ear0/ECE445_Team18/README.md

# S-band Radar Altimeter
Welcome to Team 18's engineering notebook detailing our attempt to build a radar altimeter.

Team members: Bobby Sommers, Elliot Rubin, Rayan Nehme

thumbnail_IMG_4961
