ear0/ECE445_Team18/notebooks/rayan/73459145394__DBE7241A-3E8F-4A33-9CC1-7CEE9B650594.pdf

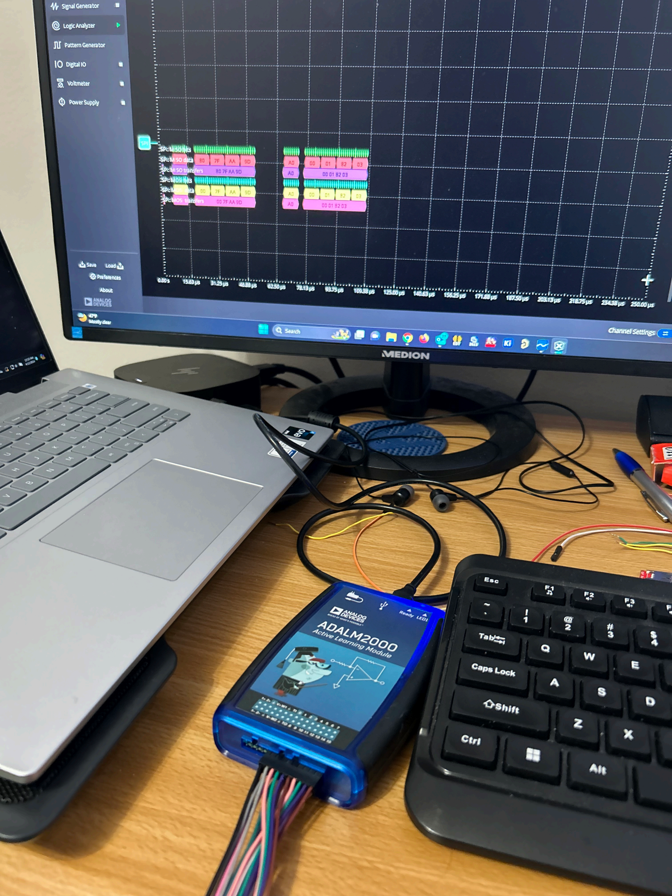
[picture p11: page 1]
