ear0/ECE445_Team18/hardware/pcb/Radar2_ExtFilter/some_s_params/Terminal S Parameter Plot 1.csv

$e_r [] | TraceW [mm] | Freq [GHz] | dB(St(Trace_T1,Trace_T1)) [] | dB(St(Trace_T2,Trace_T2)) []
4.2 | 0.15 | 2 | -15.2933460259408 | -14.9864315408136
4.2 | 0.15 | 2.0025 | -15.2792393182591 | -14.9737543382061
4.2 | 0.15 | 2.005 | -15.2651536047298 | -14.9610933365723
4.2 | 0.15 | 2.0075 | -15.2510889968198 | -14.9484486654774
4.2 | 0.15 | 2.01 | -15.2370456068577 | -14.9358204513786
4.2 | 0.15 | 2.0125 | -15.2230235480281 | -14.9232088178172
4.2 | 0.15 | 2.015 | -15.2090229343641 | -14.9106138856007
4.2 | 0.15 | 2.0175 | -15.1950438807411 | -14.8980357729761
4.2 | 0.15 | 2.02 | -15.1810865028692 | -14.8854745957944
4.2 | 0.15 | 2.0225 | -15.1671509172862 | -14.8729304676672
4.2 | 0.15 | 2.025 | -15.1532372413499 | -14.8604035001157
4.2 | 0.15 | 2.0275 | -15.1393455932309 | -14.8478938027121
4.2 | 0.15 | 2.03 | -15.1254760919041 | -14.8354014832142
4.2 | 0.15 | 2.0325 | -15.1116288571415 | -14.822926647694
4.2 | 0.15 | 2.035 | -15.0978040095032 | -14.8104694006593
4.2 | 0.15 | 2.0375 | -15.0840016703299 | -14.7980298451698
4.2 | 0.15 | 2.04 | -15.0702219617335 | -14.7856080829478
4.2 | 0.15 | 2.0425 | -15.056465006589 | -14.7732042144834
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
