ear0/ECE445_Team18/hardware/pcb/Radar2_ExtFilter/some_s_params/Zin.csv

$e_r [] | TraceW [mm] | Freq [GHz] | re(Zin) [] | im(Zin) []
4.2 | 0.15 | 2 | 42.0965059819982 | -13.927181922279
4.2 | 0.15 | 2.0025 | 42.0674469992557 | -13.9351497485285
4.2 | 0.15 | 2.005 | 42.0383466433968 | -13.9430374163889
4.2 | 0.15 | 2.0075 | 42.0092052572373 | -13.9508445249915
4.2 | 0.15 | 2.01 | 41.9800231885834 | -13.9585706745552
4.2 | 0.15 | 2.0125 | 41.9508007902491 | -13.9662154664471
4.2 | 0.15 | 2.015 | 41.9215384200723 | -13.9737785032422
4.2 | 0.15 | 2.0175 | 41.8922364409308 | -13.9812593887849
4.2 | 0.15 | 2.02 | 41.8628952207575 | -13.98865772825
4.2 | 0.15 | 2.0225 | 41.8335151325541 | -13.9959731282054
4.2 | 0.15 | 2.025 | 41.8040965544055 | -14.0032051966738
4.2 | 0.15 | 2.0275 | 41.7746398694918 | -14.0103535431966
4.2 | 0.15 | 2.03 | 41.7451454661006 | -14.0174177788969
4.2 | 0.15 | 2.0325 | 41.7156137376384 | -14.024397516544
4.2 | 0.15 | 2.035 | 41.6860450826408 | -14.0312923706177
4.2 | 0.15 | 2.0375 | 41.6564399047821 | -14.0381019573734
4.2 | 0.15 | 2.04 | 41.6267986128838 | -14.0448258949076
4.2 | 0.15 | 2.0425 | 41.5971216209233 | -14.051463803224
4.2 | 0.15 | 2.045 | 41.5674093480402 | -14.0580153042993
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
