ear0/ECE445_Team18/hardware/pcb/PA_EVAL/PA_EVAL_back.png

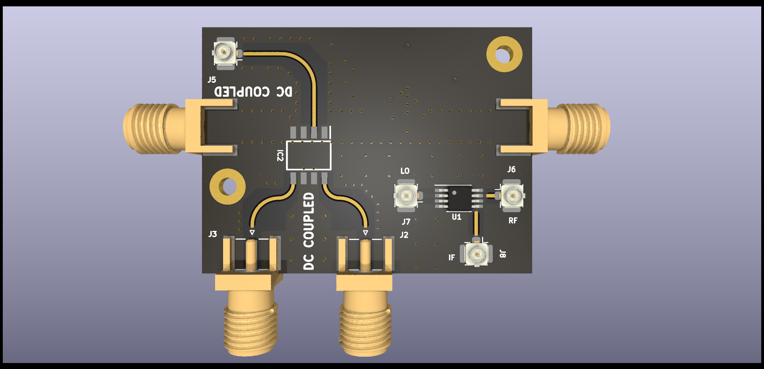
hardware/pcb/PA_EVAL/PA_EVAL_back.png
