ear0/ECE445_Team18/hardware/pcb/power_processing_unit/power_processing_unit.png

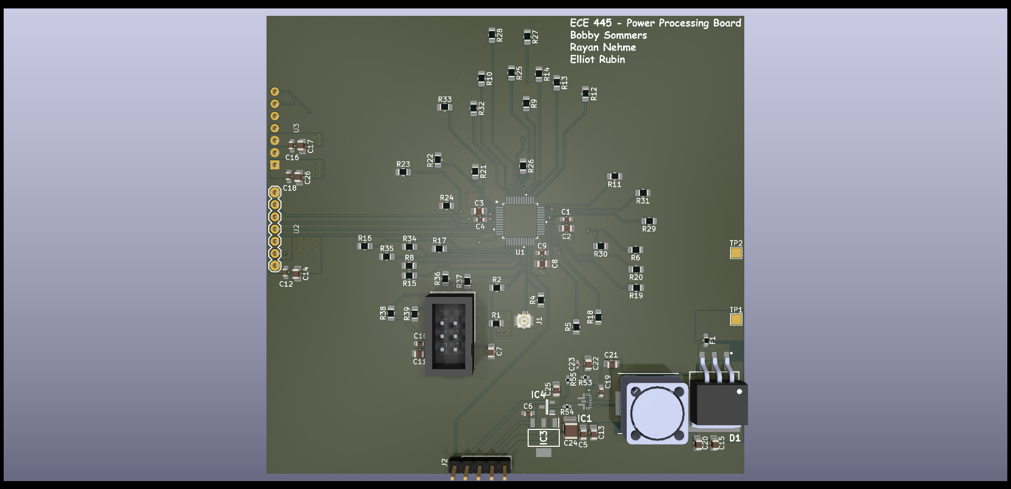
hardware/pcb/power_processing_unit/power_processing_unit.png
