ear0/ECE445_Team18/hardware/pcb/RadarV1.5/Radar2_ExtFilterUSE/Radar2_ExtFilter.png

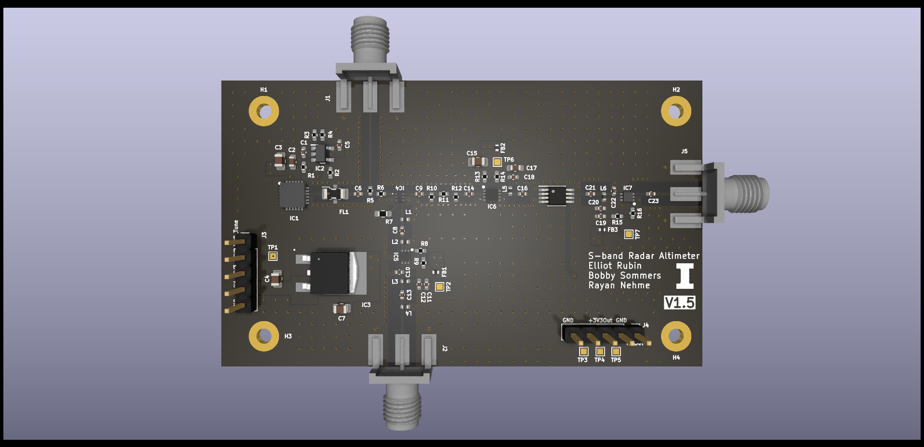
hardware/pcb/RadarV1.5/Radar2_ExtFilterUSE/Radar2_ExtFilter.png
