ear0/ECE445_Team18/hardware/pcb/PA_EVAL/PA_EVAL.step

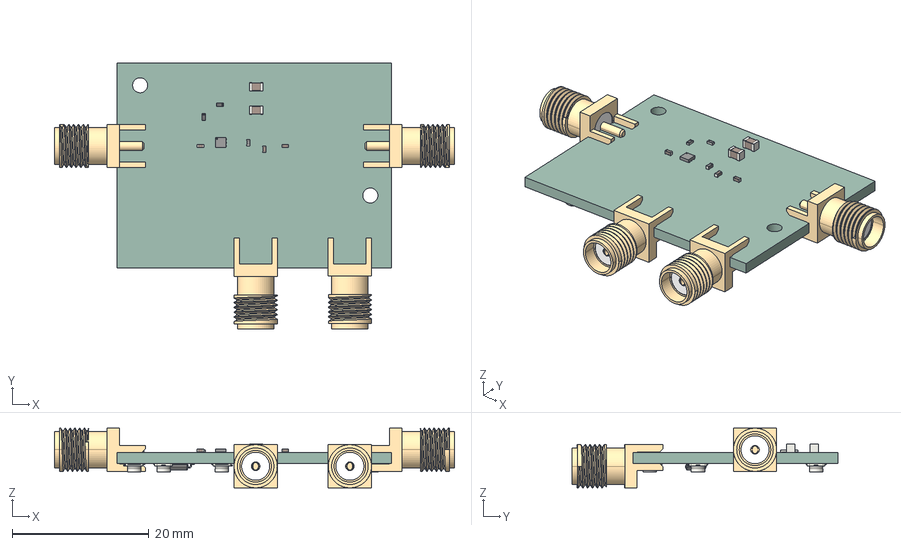
[picture p18: CAD file, 2024-05-02]
hardware/pcb/PA_EVAL/PA_EVAL.step
58.6 x 39.0 x 8.77 mm
R_0402_1005Metric x 2
C_0805_2012Metric x 2
C_0402_1005Metric x 3
ASSEMBLY
SMA-J-P-H-ST-EM1 x 4
L_0402_1005Metric
MSOP_8_3x3mm_P065mm
U.FL_Hirose_U.FL-R-SMT-1_Vertical x 4
PA_EVAL PCB
