ear0/ECE445_Team18/hardware/pcb/power_processing_unit/LIB_ADP150AUJZ-3/ADP150AUJZ-3.0-R7/3D/ADP150AUJZ-3.0-R7.stp

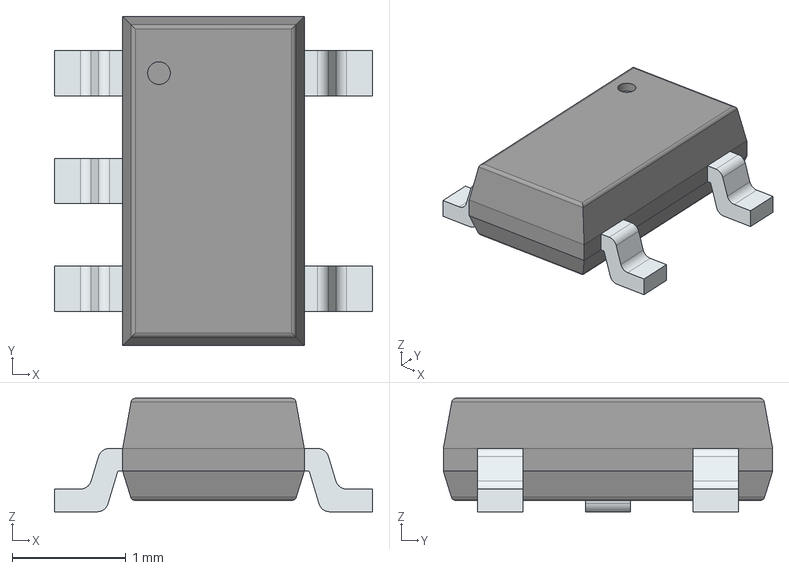
[picture p19: CAD file, 2024-05-02]
hardware/pcb/power_processing_unit/LIB_ADP150AUJZ-3/ADP150AUJZ-3.0-R7/3D/ADP150AUJZ-3.0-R7.stp
2.80 x 2.90 x 1.00 mm
PinsArrayL
PinsArrayR
