ear0/ECE445_Team18/hardware/pcb/power_processing_unit/LIB_AP7375-50SA-7/AP7375-50SA-7/3D/AP7375-50SA-7.stp

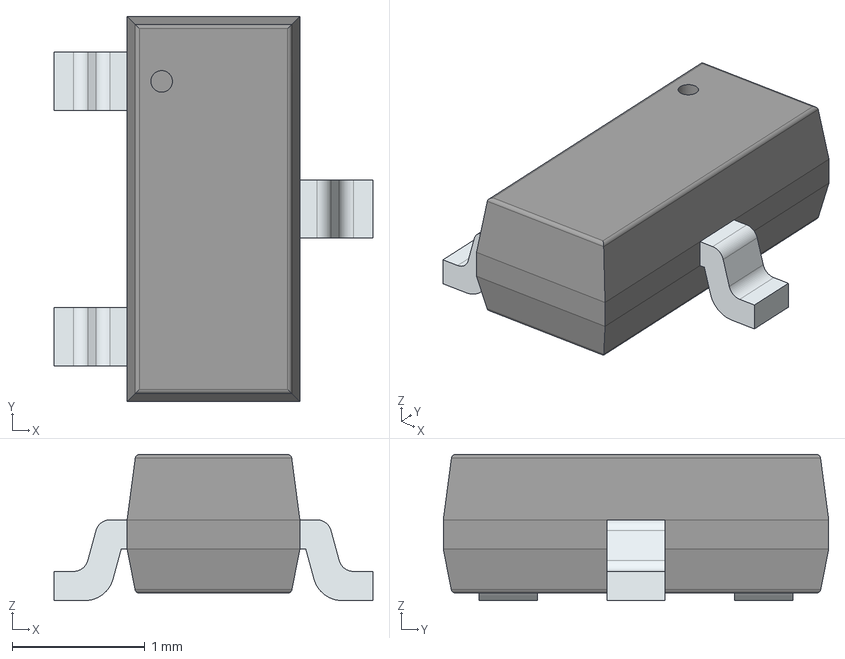
[picture p20: CAD file, 2024-05-02]
hardware/pcb/power_processing_unit/LIB_AP7375-50SA-7/AP7375-50SA-7/3D/AP7375-50SA-7.stp
2.40 x 2.90 x 1.10 mm
PinsArrayL
FilletPinR
