ear0/ECE445_Team18/hardware/pcb/power_processing_unit/LIB_AZ1117CH2-3/AZ1117CH2-3.3TRG1/3D/AZ1117CH2-3.3TRG1.stp

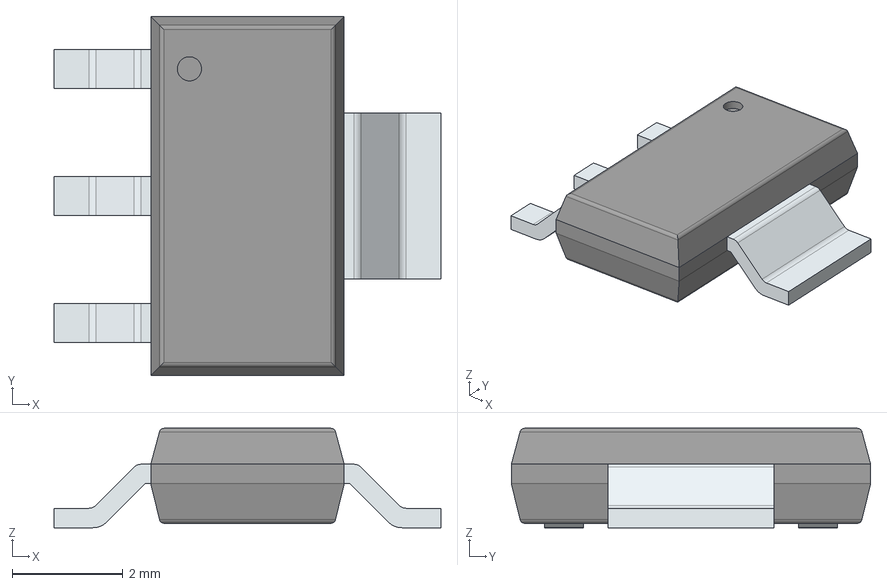
[picture p21: CAD file, 2024-05-02]
hardware/pcb/power_processing_unit/LIB_AZ1117CH2-3/AZ1117CH2-3.3TRG1/3D/AZ1117CH2-3.3TRG1.stp
7.00 x 6.50 x 1.80 mm
PinsArrayL
FilletPinR
