ear0/ECE445_Team18/hardware/pcb/power_processing_unit/LIB_DR127-3R3-R/DR127-3R3-R/3D/DR127-3R3-R.stp

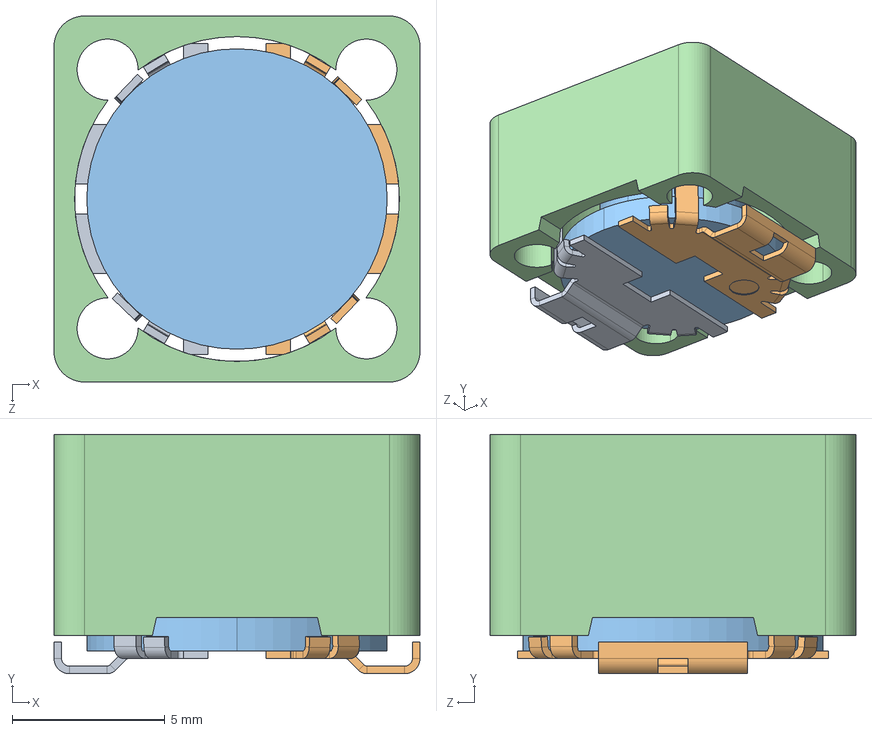
[picture p22: CAD file, 2024-05-02]
hardware/pcb/power_processing_unit/LIB_DR127-3R3-R/DR127-3R3-R/3D/DR127-3R3-R.stp
12.0 x 7.85 x 12.0 mm
40014700A
