ear0/ECE445_Team18/hardware/pcb/Radar2_ExtFilter/Imported Full_Radar/Radar2_ExtFilter.step

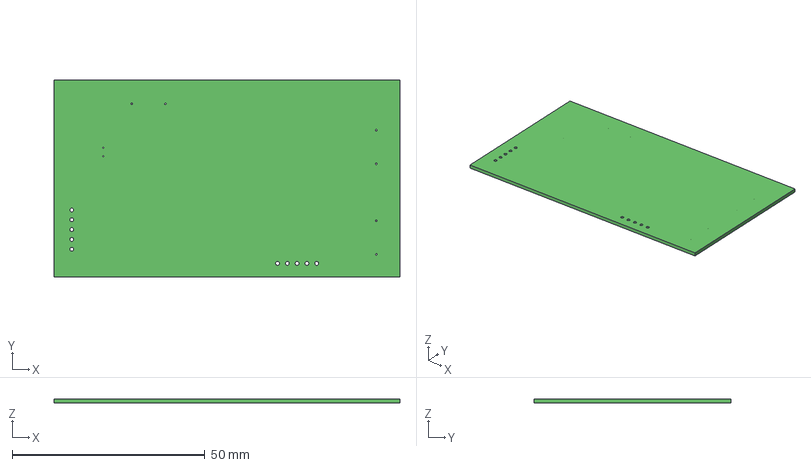
[picture p23: CAD file, 2024-05-02]
hardware/pcb/Radar2_ExtFilter/Imported Full_Radar/Radar2_ExtFilter.step
89.7 x 51.0 x 1.12 mm
