ear0/ECE445_Team18/hardware/pcb/power_processing_unit/2power_processing_unit.step

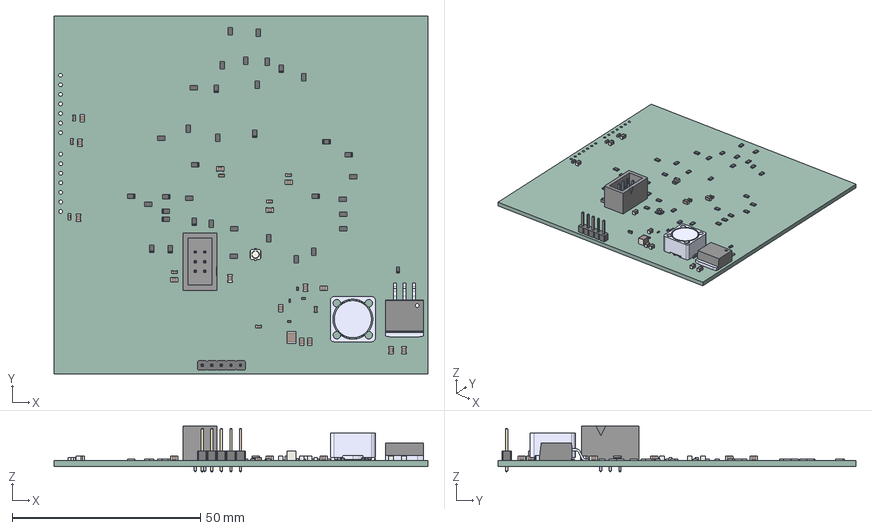
[picture p24: CAD file, 2024-05-02]
hardware/pcb/power_processing_unit/2power_processing_unit.step
99.3 x 95.1 x 12.1 mm
R_0402_1005Metric x 3
C_0603_1608Metric x 9
R_0805_2012Metric x 37
C_0805_2012Metric x 15
DR127
PinHeader_1x05_P254mm_Vertical
U.FL_Hirose_U.FL-R-SMT-1_Vertical
C_1210_3225Metric
Fuse_0603_1608Metric
C_0402_1005Metric
LM337KTTR
ASSEMBLY
power_processing_unit PCB
