ear0/ECE445_Team18/hardware/pcb/power_processing_unit/LIB_61200621621/61200621621/3D/61200621621.stp

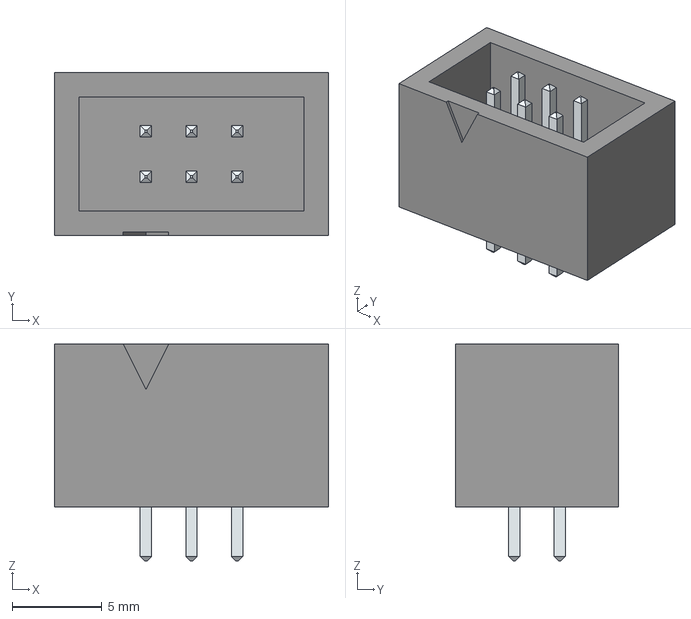
[picture p25: CAD file, 2024-05-02]
hardware/pcb/power_processing_unit/LIB_61200621621/61200621621/3D/61200621621.stp
15.3 x 9.10 x 12.1 mm
LeadsArray
