ear0/ECE445_Team18/hardware/pcb/power_processing_unit/LIB_SM74611KTTR/SM74611KTTR/3D/SM74611KTTR.stp

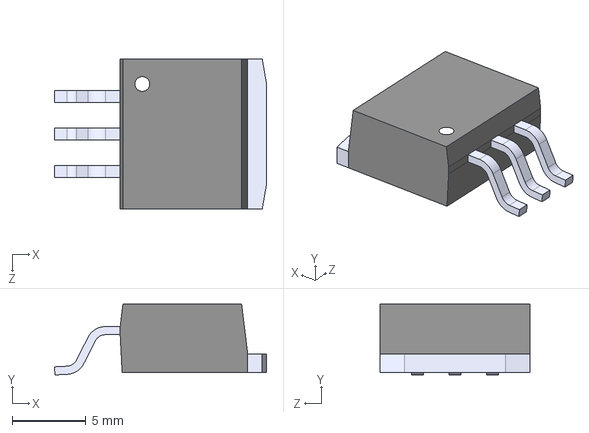
[picture p26: CAD file, 2024-05-02]
hardware/pcb/power_processing_unit/LIB_SM74611KTTR/SM74611KTTR/3D/SM74611KTTR.stp
14.4 x 4.80 x 10.2 mm
