ear0/ECE445_Team18/hardware/pcb/power_processing_unit/LIB_TPS61288RQQR/TPS61288RQQR/3D/TPS61288RQQR.stp

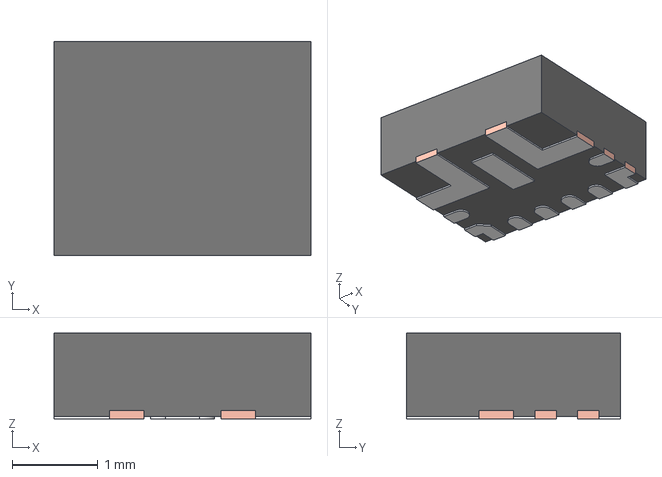
[picture p27: CAD file, 2024-05-02]
hardware/pcb/power_processing_unit/LIB_TPS61288RQQR/TPS61288RQQR/3D/TPS61288RQQR.stp
3.00 x 2.50 x 1.00 mm
FRAME
MOLD
