ear0/ECE445_Team18/(list of files, cad)

Other CAD files:
hardware/pcb/power_processing_unit/power_processing_unit.dxf
hardware/pcb/RadarV1.5/Radar2_ExtFilterUSE/Radar2_ExtFilter.dxf
hardware/pcb/power_processing_unit/2power_processing_unit/2power_processing_unit.ipt
hardware/pcb/power_processing_unit/LIB_61200621621/61200621621/Allegro/shdr6w64p254_2x3_1528x910x910p.psm
hardware/pcb/power_processing_unit/LIB_61200621621/61200621621/DEHDL/61200621621/chips/chips.prt
hardware/pcb/power_processing_unit/LIB_ADP150AUJZ-3/ADP150AUJZ-3.0-R7/Allegro/sot95p280x100-5n.psm
hardware/pcb/power_processing_unit/LIB_ADP150AUJZ-3/ADP150AUJZ-3.0-R7/DEHDL/adp150aujz_3.0_r7/chips/chips.prt
hardware/pcb/power_processing_unit/LIB_AP7375-50SA-7/AP7375-50SA-7/Allegro/sot96p240x110-3n.psm
hardware/pcb/power_processing_unit/LIB_AP7375-50SA-7/AP7375-50SA-7/DEHDL/ap7375_50sa_7/chips/chips.prt
hardware/pcb/power_processing_unit/LIB_AZ1117CH2-3/AZ1117CH2-3.3TRG1/Allegro/sot230p700x180-4n.psm
hardware/pcb/power_processing_unit/LIB_AZ1117CH2-3/AZ1117CH2-3.3TRG1/DEHDL/az1117ch2_3.3trg1/chips/chips.prt
hardware/pcb/power_processing_unit/LIB_DR127-3R3-R/DR127-3R3-R/Allegro/indpm125125x800n.psm
hardware/pcb/power_processing_unit/LIB_DR127-3R3-R/DR127-3R3-R/DEHDL/dr127_3r3_r/chips/chips.prt
hardware/pcb/power_processing_unit/LIB_PIC24FJ128GC010-I_PT/PIC24FJ128GC010-I_PT/Allegro/qfp40p1400x1400x120-100n.psm
hardware/pcb/power_processing_unit/LIB_PIC24FJ128GC010-I_PT/PIC24FJ128GC010-I_PT/DEHDL/pic24fj128gc010_i_pt/chips/chips.prt
hardware/pcb/power_processing_unit/LIB_SM74611KTTR/SM74611KTTR/Allegro/to254p1524x483-4n.psm
hardware/pcb/power_processing_unit/LIB_SM74611KTTR/SM74611KTTR/DEHDL/sm74611kttr/chips/chips.prt
hardware/pcb/power_processing_unit/LIB_TPS61230ARNSR/TPS61230ARNSR/Allegro/rns0007a.psm
hardware/pcb/power_processing_unit/LIB_TPS61230ARNSR/TPS61230ARNSR/DEHDL/tps61230arnsr/chips/chips.prt
hardware/pcb/power_processing_unit/LIB_TPS61288RQQR/TPS61288RQQR/Allegro/tps61288rqqr.psm
hardware/pcb/power_processing_unit/LIB_TPS61288RQQR/TPS61288RQQR/DEHDL/tps61288rqqr/chips/chips.prt
