ear0/ECE445_Team18/hardware/pcb/power_processing_unit/power_processing_unit.pdf

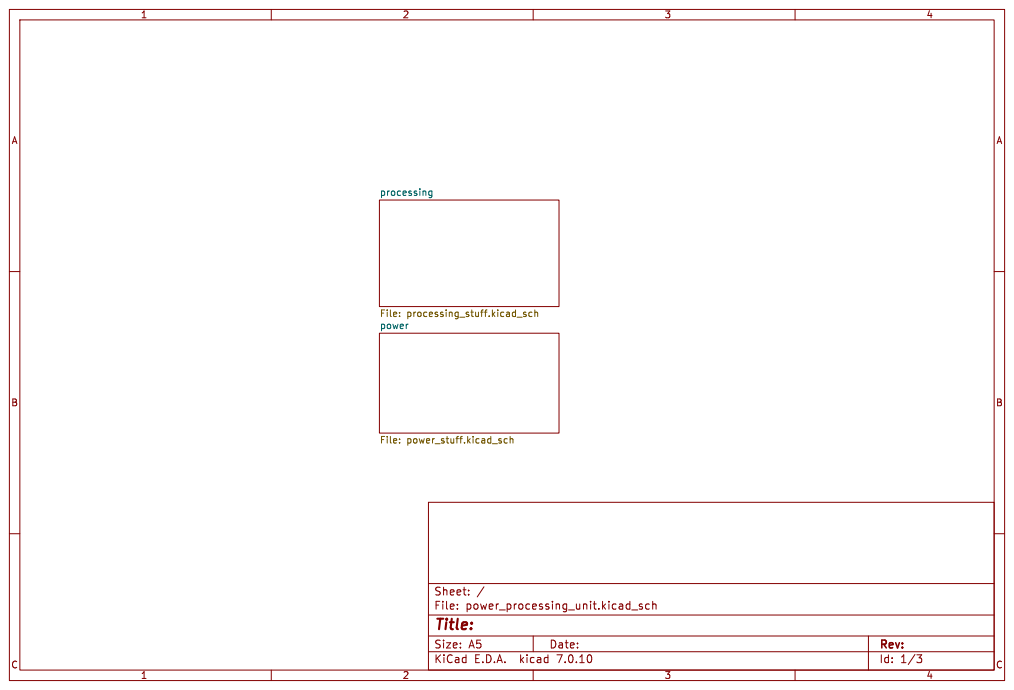
[picture p28: page 1]

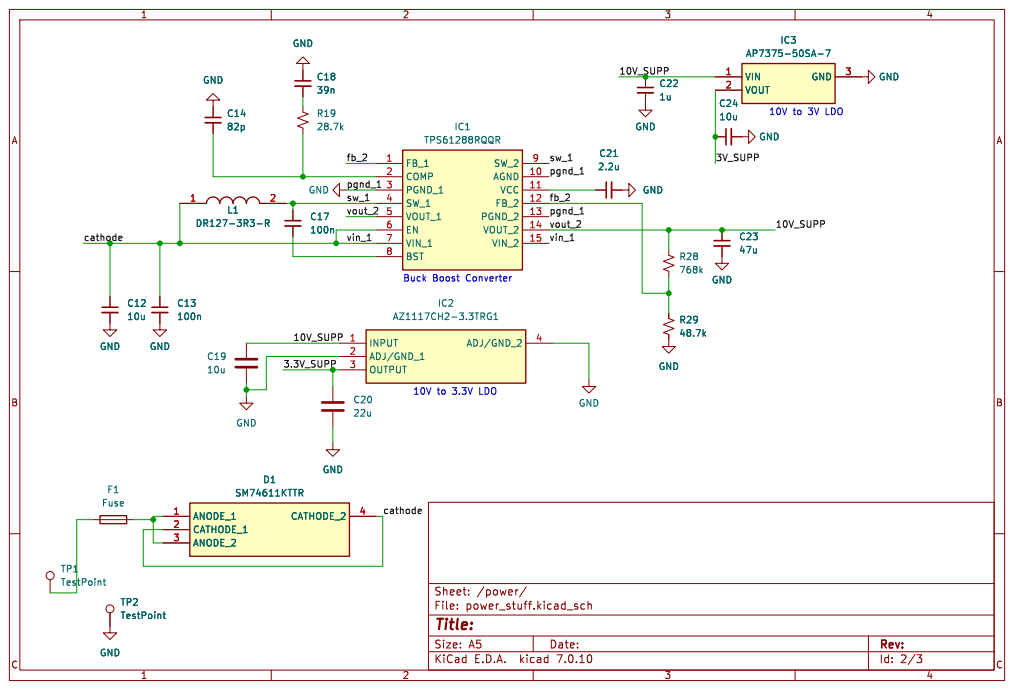
[picture p29: page 2]

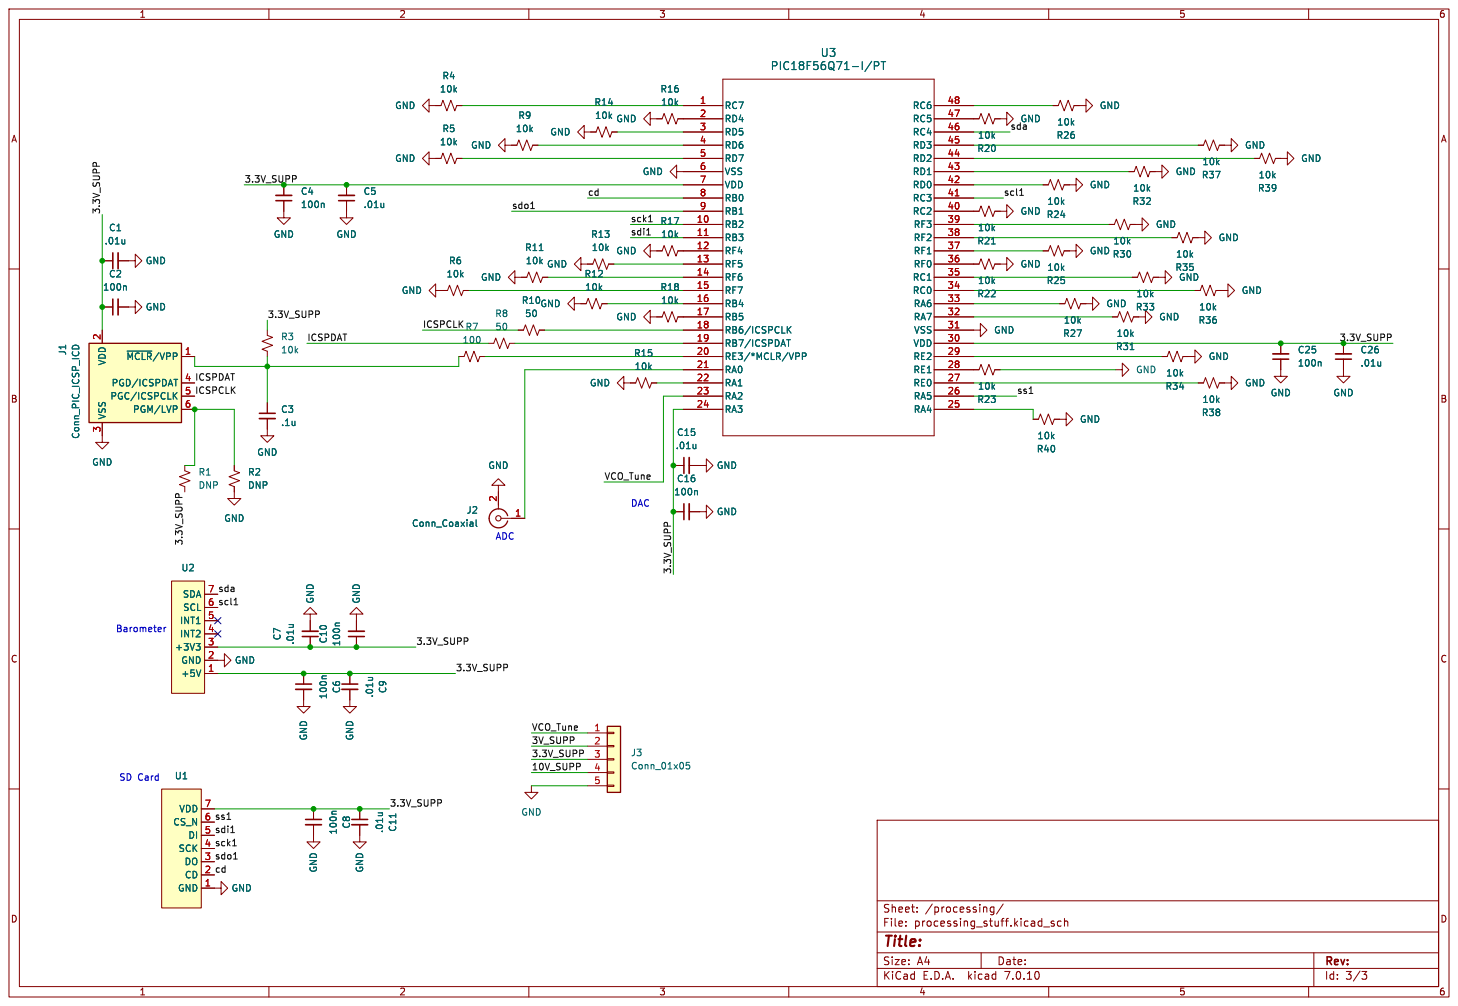
[picture p30: page 3]

3 PGD/ICSPDAT 4 PGC/ICSPCLK 5 PGM/LVP 6 J1 Conn_PIC_ICSP_ICD

3 PGD/ICSPDAT 4 PGC/ICSPCLK 5 PGM/LVP 6 C3

Id: 3/3 Title: File: processing_stuff.kicad_sch Sheet: /processing/
