ear0/ECE445_Team18/hardware/pcb/RadarV1.5/Radar2_ExtFilterUSE/Radar2_ExtFilter.pdf

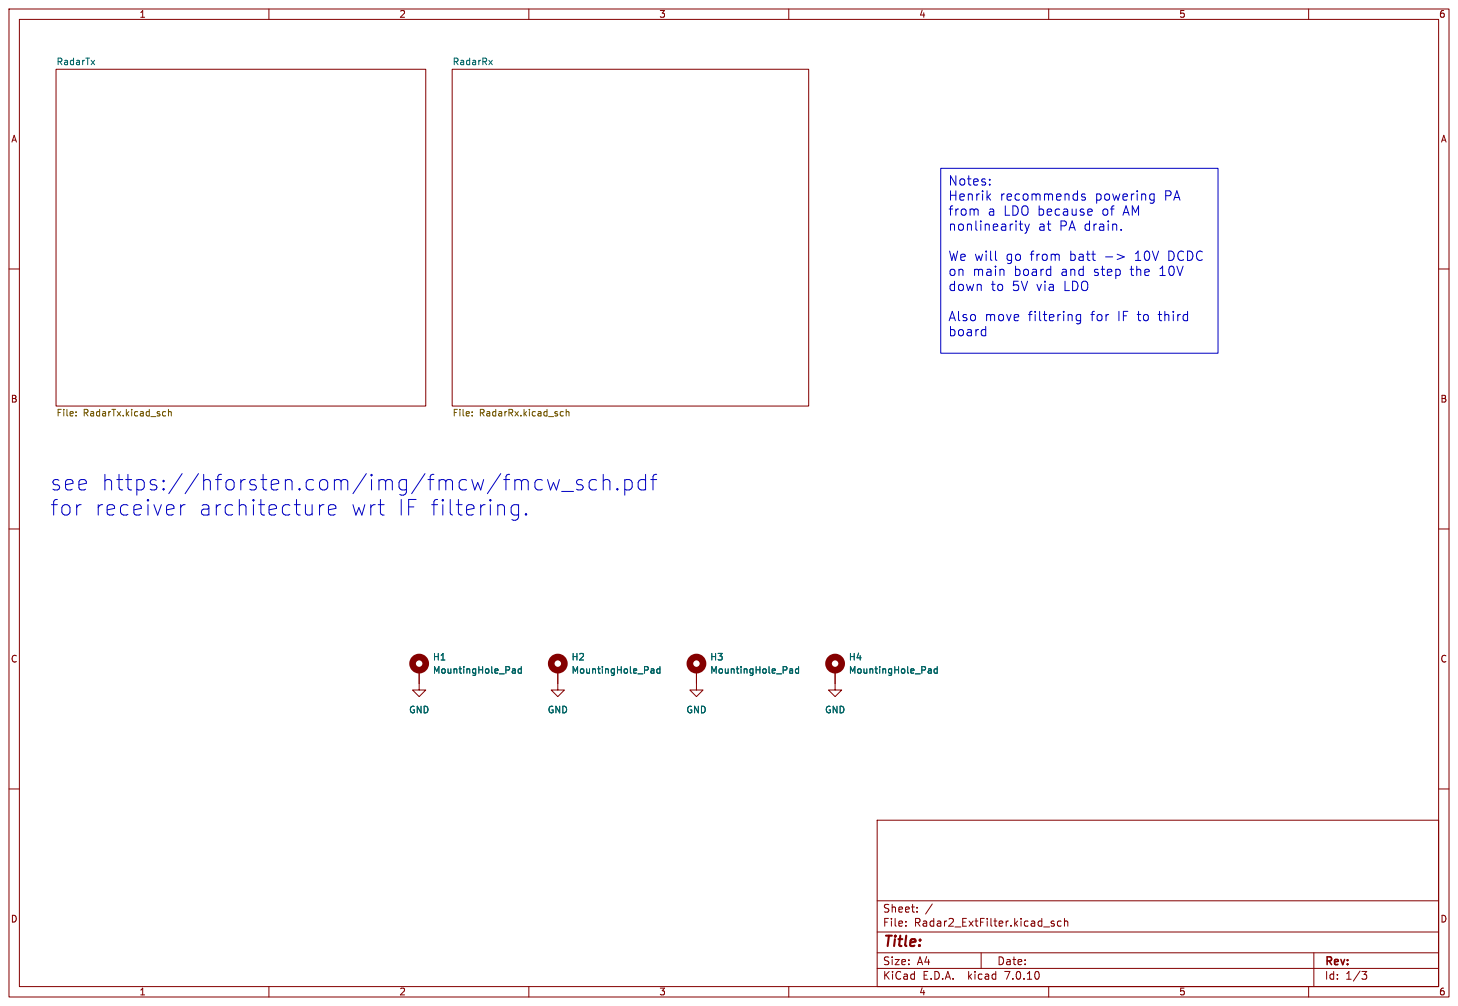
[picture p31: page 1]

H4 MountingHole_Pad GND see https://hforsten.com/img/fmcw/fmcw_sch.pdf

Id: 1/3 Title: File: Radar2_ExtFilter.kicad_sch Sheet: /

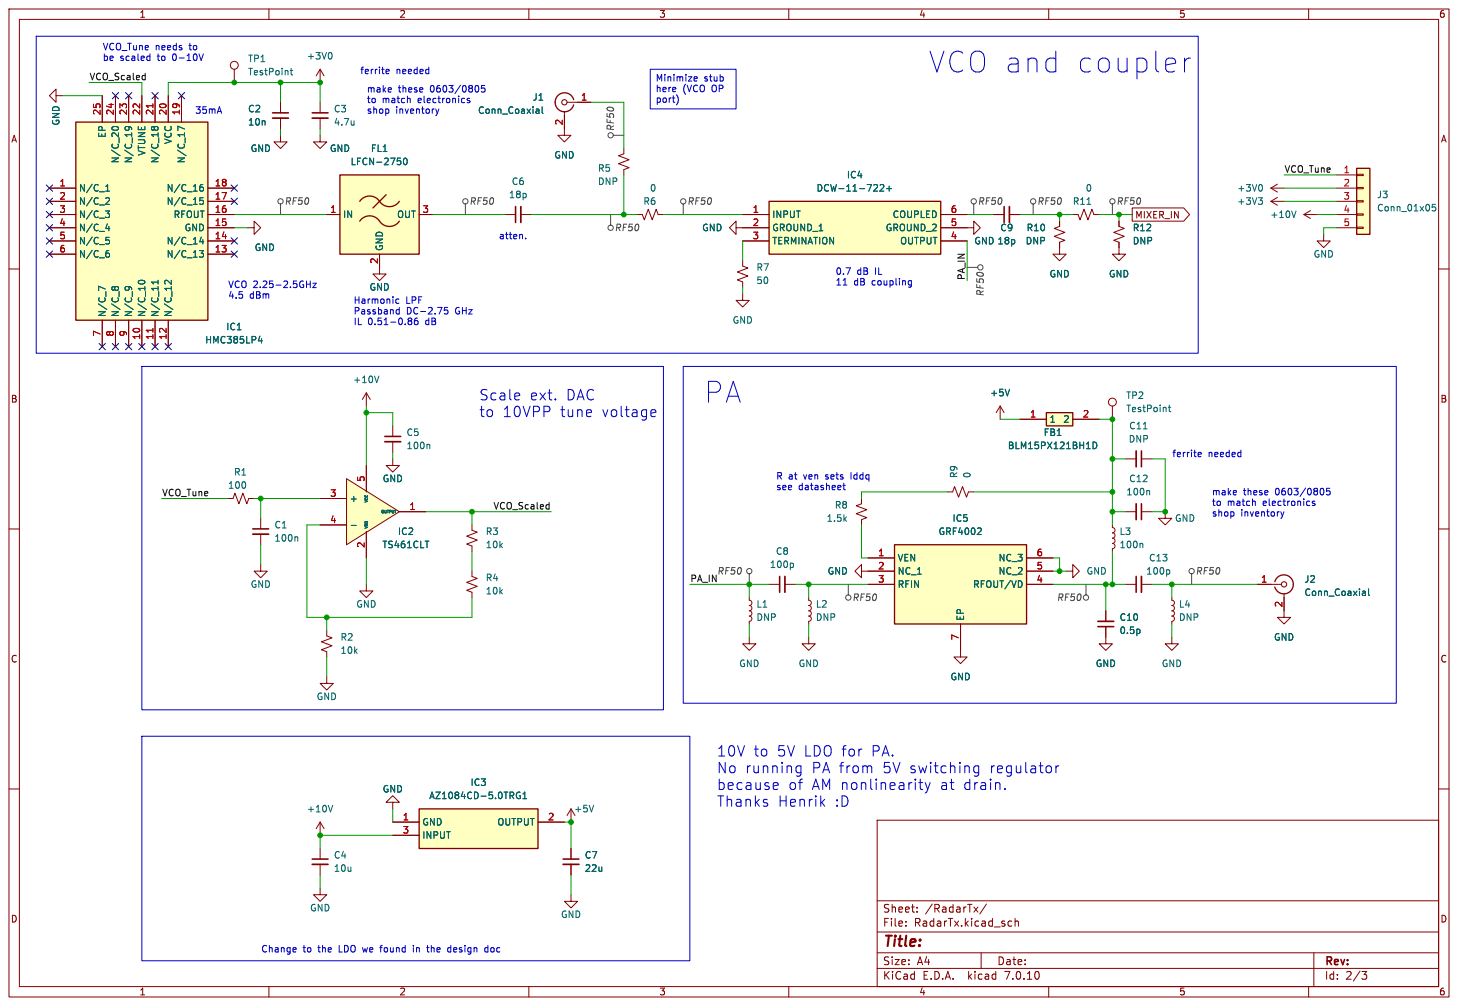
[picture p32: page 2]

ferrite needed make these 0603/0805

R at ven sets Iddq
see datasheet

10V to 5V LDO for PA.
Thanks Henrik :D

Id: 2/3 Title: File: RadarTx.kicad_sch Sheet: /RadarTx/

Change to the LDO we found in the design doc

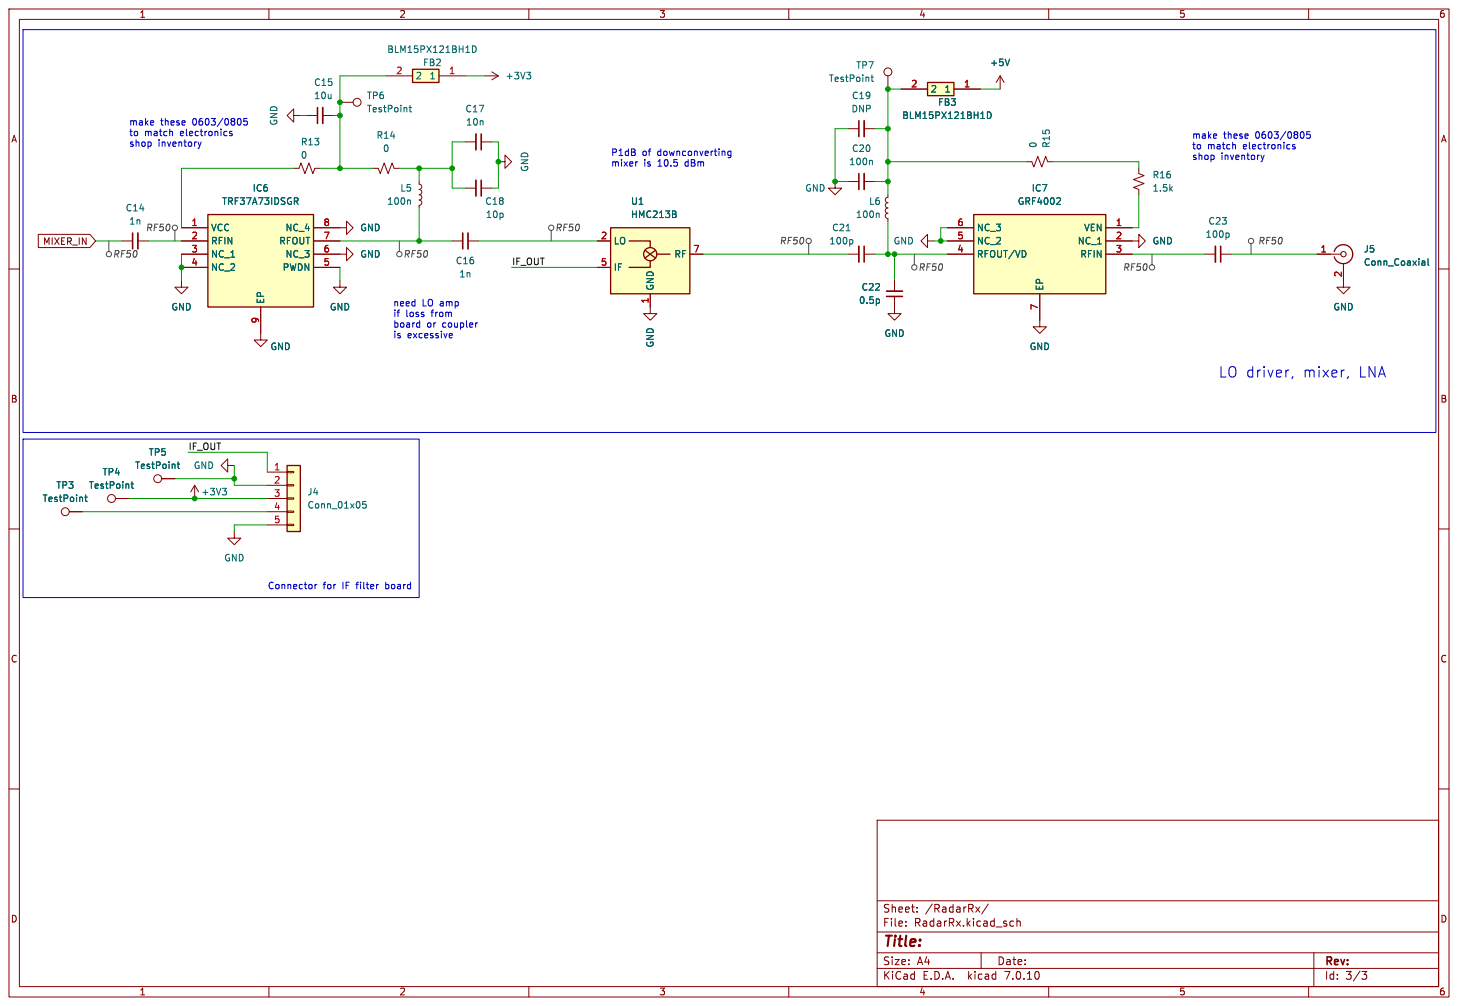
[picture p33: page 3]

9 TP3 TestPoint TP5 TestPoint TP4 TestPoint GND

LO driver, mixer, LNA

Id: 3/3 Title: File: RadarRx.kicad_sch Sheet: /RadarRx/
