ear0/ECE445_Team18/hardware/pcb/RadarV1.5/Radar2_ExtFilterUSE/Group18_ProductionFiles/Radar2_ExtFilter.pdf

Id: 1/3 Title: File: Radar2_ExtFilter.kicad_sch Sheet: /

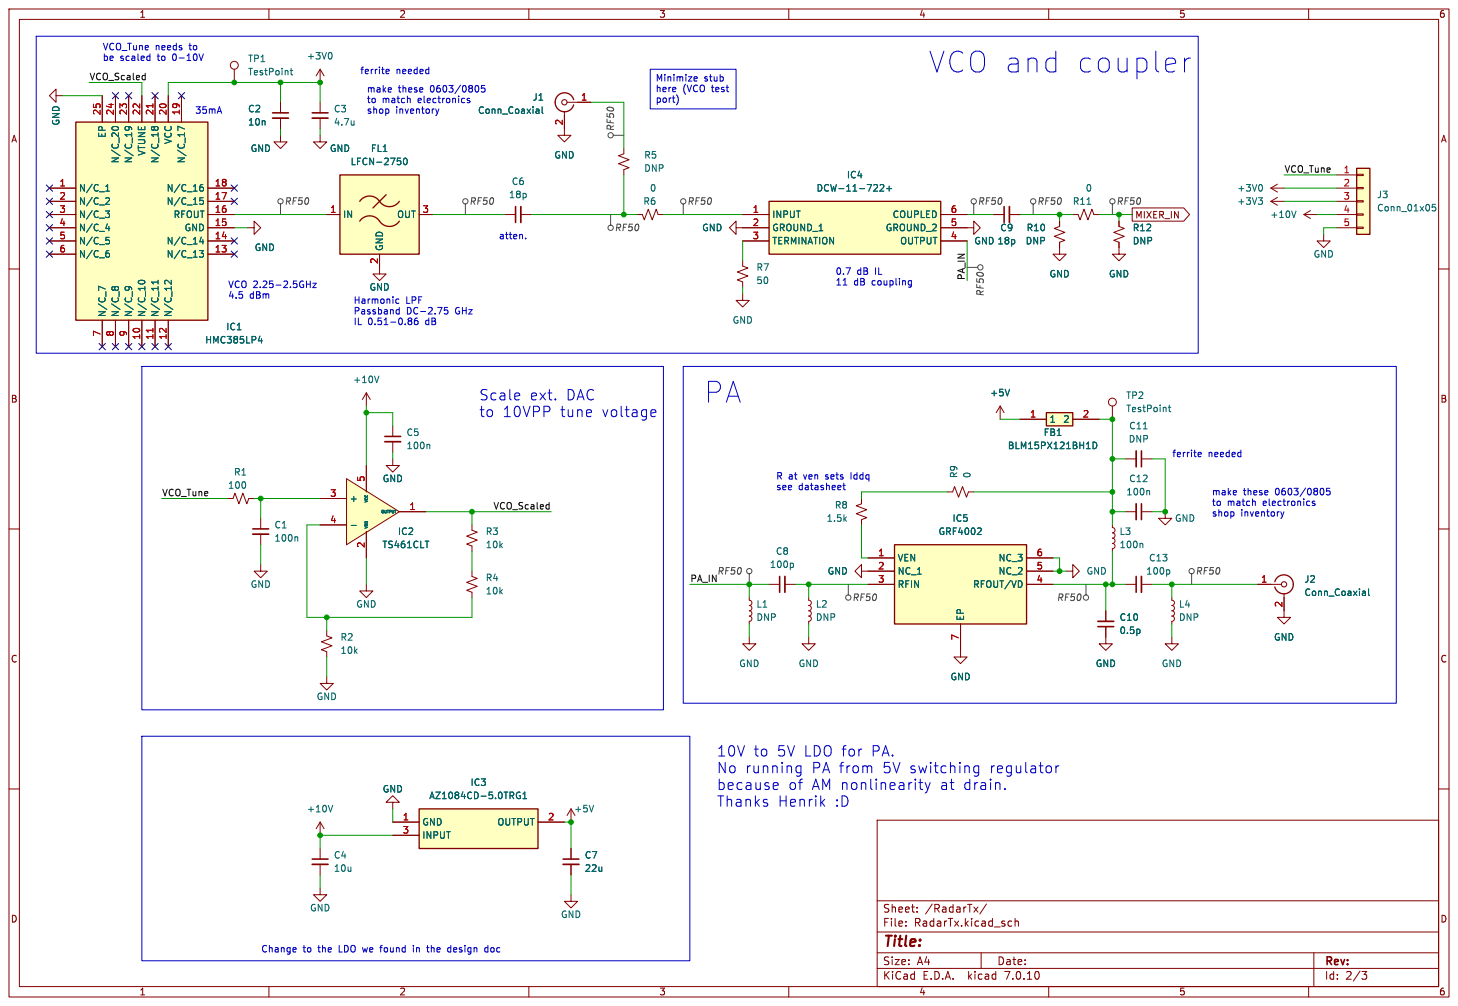
[picture p34: page 2]

see datasheet 10V to 5V LDO for PA.

Id: 2/3 Title: File: RadarTx.kicad_sch Sheet: /RadarTx/


9 TP3 TestPoint TP5 TestPoint TP4 TestPoint GND

LO driver, mixer, LNA

Id: 3/3 Title: File: RadarRx.kicad_sch Sheet: /RadarRx/
