ear0/ECE445_Team18/hardware/pcb/PA_EVAL/PA_EVAL.pdf

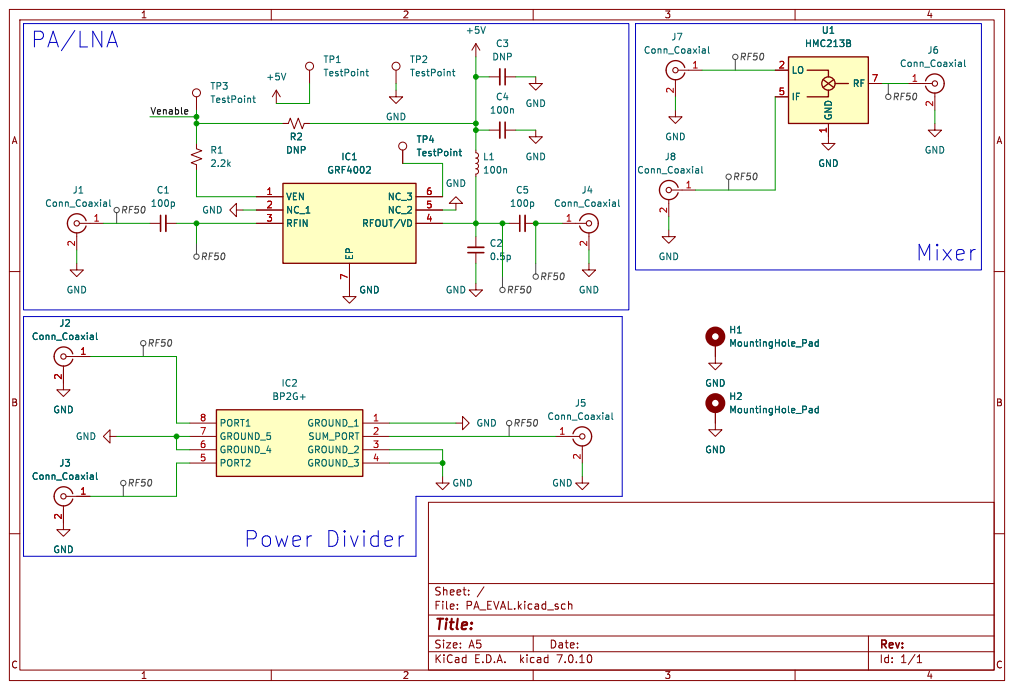
[picture p35: page 1]

TP4 TestPoint
