ear0/ECE445_Team18/hardware/pcb/IFBoard/BP_antialiasing/LTspice/ACAnalysis.asc

STAGE1: StageB_BandPassDeliyannisFriendNoPosFB_LTC6262
STAGE2: StageC_BandPassDeliyannisFriendNoPosFB_LTC6262
STAGE3: StageA_BandPassDeliyannisFriendPosFBnoR2_LTC6262
V1: voltage; 1.65
V2: voltage; 3.3
V3: voltage; 0
VIN: voltage; SINE(1.65 159m 311); AC 1
Named nets: 0, Vp, Vn, OUT1, Vref, IN, OUT2, OUT
.AC DEC 100 311 80.3k 
.save V(*?*) I(*?*)
If you're having trouble with simulation try the following:
 
- Ensure that LTspice circuit folder is unzipped.  LTspice won't 
be able to locate subcircuits if the folders are still zipped.
 
- Update LTspice - devices that have been recently added to LTspice
won't be available unless you update by clicking Tools -> Sync Release.
