ear0/ECE445_Team18/hardware/pcb/IFBoard/BP_antialiasing/LTspice/StageA_BandPassDeliyannisFriendPosFBnoR2_LTC6262.asc

C1: cap; 3.3n
C2: cap; 3.3n
R1: res; 47k
R3: res; 15k
R4: res; 680
R5: res; 2.2k
U1: LTC6262
Named nets: V+, V-, OUT, IN, REF, Vp
This subcircuit is not simulatable.  
Please open one of the 
"Filter Design*.asc" schematics to 
simulate your Filter Wizard design.
