ear0/ECE445_Team18/hardware/pcb/IFBoard/BP_antialiasing/LTspice/StageB_BandPassDeliyannisFriendNoPosFB_LTC6262.asc

C1: cap; 1.5n
C2: cap; 1.5n
R1: res; 4.7k
R2: res; 22k
R5: res; 33k
U1: LTC6262
Named nets: V+, V-, OUT, IN, REF, Vp
This subcircuit is not simulatable.  
Please open one of the 
"Filter Design*.asc" schematics to 
simulate your Filter Wizard design.
