ear0/ECE445_Team18/hardware/pcb/IFBoard/DesignFilesBetterTols/LTspice/Draft1.asc

C1: cap; 1.59n
R1: res; 100k
R2: res; 100Meg
U1: TLV9002
V1: voltage; 3.3
V2: voltage; PULSE(0 3.3 0 0.01m 0.01m 0.5m 1m)
V3: voltage; 3.3
V4: voltage; -780µ
Named nets: 3V3, Vout, 0, -3V3
.tran 100m
