ear0/ECE445_Team18/hardware/pcb/IFBoard/DesignFilesBetterTols/LTspice/StageA_BandPassDeliyannisFriendPosFBnoR2_LTC6262.asc

C1: cap; 3.3n
C2: cap; 3.3n
R1: res; 39k
R3: res; 12k
R4: res; 470
R5: res; 2.7k
U1: LTC6262
Named nets: V+, V-, OUT, IN, REF, Vp
This subcircuit is not simulatable.  
Please open one of the 
"Filter Design*.asc" schematics to 
simulate your Filter Wizard design.
