ear0/ECE445_Team18/hardware/pcb/IFBoard/DesignFilesBetterTols/LTspice/StageC_BandPassDeliyannisFriendNoPosFB_LTC6262.asc

C1: cap; 6.8n
C2: cap; 6.8n
R1: res; 3.9k
R2: res; 18k
R5: res; 33k
U1: LTC6262
Named nets: V+, V-, OUT, IN, REF, Vp
This subcircuit is not simulatable.  
Please open one of the 
"Filter Design*.asc" schematics to 
simulate your Filter Wizard design.
