ear0/ECE445_Team18/(list of files, drawings)

Other design files:
hardware/pcb/IFBoard/freerouting.dsn
hardware/pcb/power_processing_unit/LIB_61200621621/61200621621/Altium/61200621621.SchLib
hardware/pcb/power_processing_unit/LIB_61200621621/61200621621/Altium/SHDR6W64P254_2X3_1528X910X910P.PcbLib
hardware/pcb/power_processing_unit/LIB_ADP150AUJZ-3/ADP150AUJZ-3.0-R7/Altium/ADP150AUJZ-3.0-R7.SchLib
hardware/pcb/power_processing_unit/LIB_ADP150AUJZ-3/ADP150AUJZ-3.0-R7/Altium/SOT95P280X100-5N.PcbLib
hardware/pcb/power_processing_unit/LIB_AP7375-50SA-7/AP7375-50SA-7/Altium/AP7375-50SA-7.SchLib
hardware/pcb/power_processing_unit/LIB_AP7375-50SA-7/AP7375-50SA-7/Altium/SOT96P240X110-3N.PcbLib
hardware/pcb/power_processing_unit/LIB_AZ1117CH2-3/AZ1117CH2-3.3TRG1/Altium/AZ1117CH2-3.3TRG1.SchLib
hardware/pcb/power_processing_unit/LIB_AZ1117CH2-3/AZ1117CH2-3.3TRG1/Altium/SOT230P700X180-4N.PcbLib
hardware/pcb/power_processing_unit/LIB_DR127-3R3-R/DR127-3R3-R/Altium/DR127-3R3-R.SchLib
hardware/pcb/power_processing_unit/LIB_DR127-3R3-R/DR127-3R3-R/Altium/INDPM125125X800N.PcbLib
hardware/pcb/power_processing_unit/LIB_PIC24FJ128GC010-I_PT/PIC24FJ128GC010-I_PT/Altium/PIC24FJ128GC010-I_PT.SchLib
hardware/pcb/power_processing_unit/LIB_PIC24FJ128GC010-I_PT/PIC24FJ128GC010-I_PT/Altium/QFP40P1400X1400X120-100N.PcbLib
hardware/pcb/power_processing_unit/LIB_TPS61288RQQR/TPS61288RQQR/Altium/TPS61288RQQR.PcbLib
hardware/pcb/power_processing_unit/LIB_TPS61288RQQR/TPS61288RQQR/Altium/TPS61288RQQR.SchLib
hardware/pcb/Radar2_ExtFilter/Imported Full_Radar.dsn/Radar2_ExtFilter.PcbDoc
hardware/pcb/Radar2_ExtFilter/Imported Full_Radar.dsn/Radar2_ExtFilter.PrjPcb
hardware/pcb/Radar2_ExtFilter/Imported Full_Radar/Full_Radar(1).PcbDoc
hardware/pcb/Radar2_ExtFilter/Imported Full_Radar/Radar2_ExtFilter.PcbDoc
hardware/pcb/Radar2_ExtFilter/Imported Full_Radar/Radar2_ExtFilter.PrjPcb
hardware/pcb/Radar2_ExtFilter/Imported Full_Radar/Radar2_ExtFilter.SchLib
hardware/pcb/Radar2_ExtFilter/Imported Full_Radar/RadarRx.SchLib
hardware/pcb/Radar2_ExtFilter/Imported Full_Radar/RadarTx.SchLib
