ear0/ECE445_Team18/(commit log)

2024-05-02 commit hw/sw
    [2power_processing_unit.ipt, 2power_processing_unit.step, 61200621621.SchLib, 61200621621.stp, ADP150AUJZ-3.0-R7.SchLib, ADP150AUJZ-3.0-R7.stp, AP7375-50SA-7.SchLib, AP7375-50SA-7.stp]
2024-05-02 Rename Screenshot 2024-05-01 at 11.14.14ΓÇ»PM.png to ss1.png
2024-05-02 Rename Screenshot 2024-05-01 at 11.13.52ΓÇ»PM.png to ss2
