ear0/ECE445_Team18/(notices)

Notices in the files:
hardware/pcb/RadarV1.5/Radar2_ExtFilterUSE/openEMS_v0.0.35-74/openEMS/hyp2mat/eagle/hairpinfilter/hairpinfilter.brd:
(c) 2012 Koen De Vleeschauwer. Licensed under GPL.
