ear0/ECE445_Team18/notebooks/bobby/73382195593__17B7E81C-DF25-499D-BB63-98DA4D898300.jpg

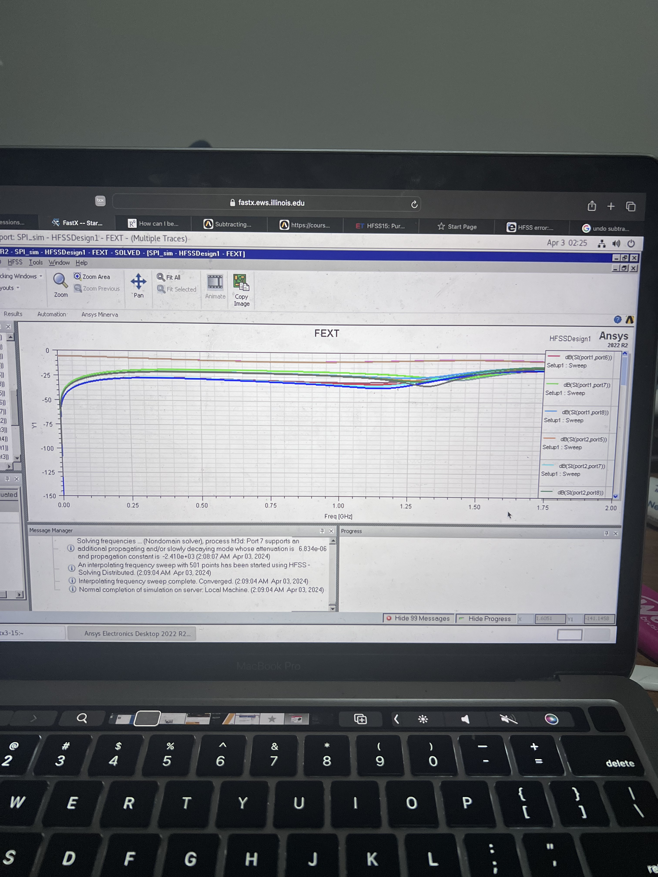
notebooks/bobby/73382195593__17B7E81C-DF25-499D-BB63-98DA4D898300.jpg
