ear0/ECE445_Team18/notebooks/bobby/73382196757__3EFE0A6F-44C4-4637-B8F2-455915C18DCE.jpg

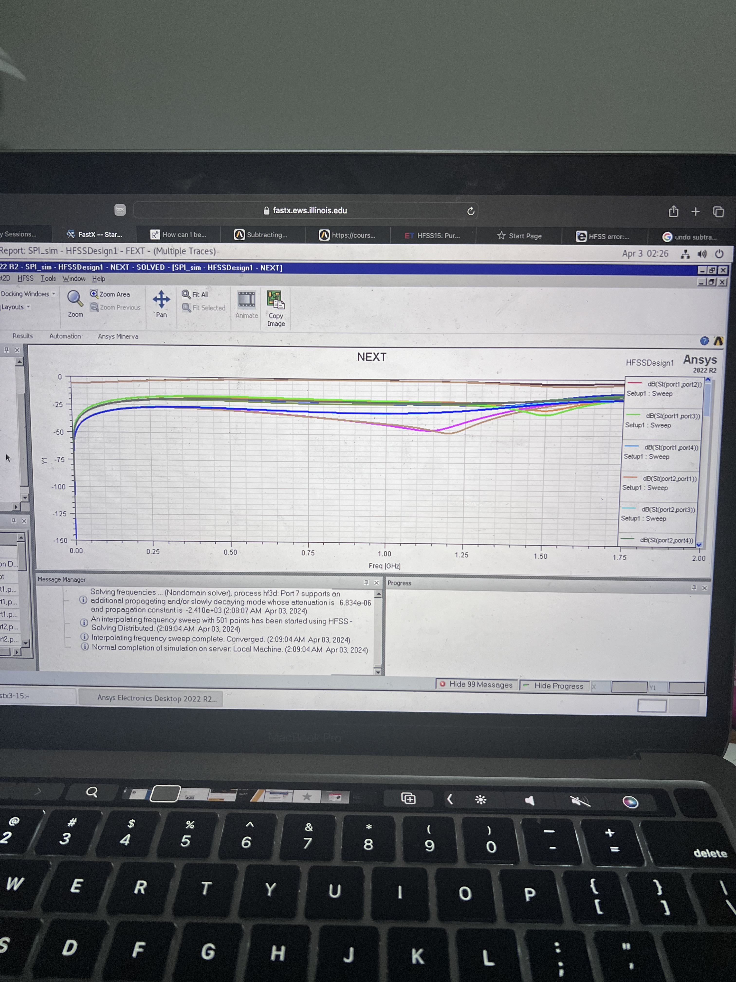
notebooks/bobby/73382196757__3EFE0A6F-44C4-4637-B8F2-455915C18DCE.jpg
